SukkoPera/OpenAmigaJoyMouseSwitcher/enclosure/README.md

# How to print

Use the 2 STL files into your favorite slicer as [Ultimaker Cura]( https://ultimaker.com/software/ultimaker-cura)

# How to improve current version

Src is in SCAD code language : [OpenAmigaJoyMouseSwitcher_Case.scad](./OpenAmigaJoyMouseSwitcher_Case.scad)

It can be modified with [Open SCAD](https://openscad.org/)

Note that the `which` variable allow you to :

- `0` display both part of the case,
- `1` display bottom part of the case (for stl export),
- `2` display top part of the case (for stl export).
