SukkoPera/OpenAmigaJoyMouseSwitcher/doc/render-bottom.png

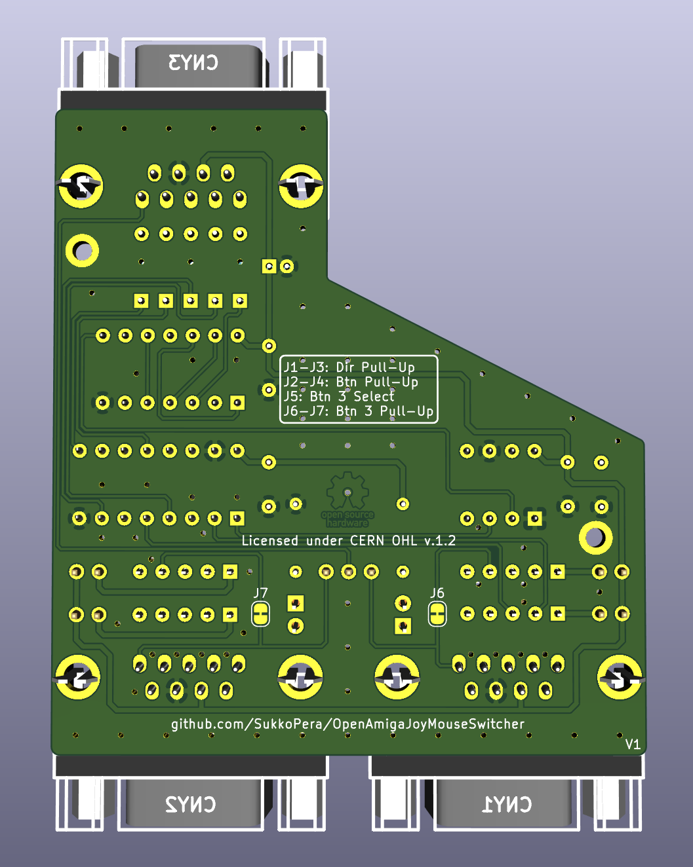
doc/render-bottom.png
