SukkoPera/OpenAmigaJoyMouseSwitcher/enclosure/OpenAmigaJoyMouseSwitcher_Case_Top.stl

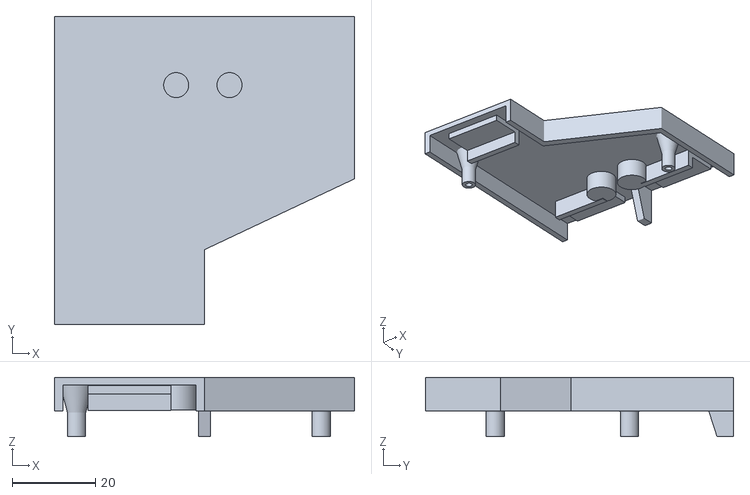
[picture p3: CAD file, 2023-03-22]
enclosure/OpenAmigaJoyMouseSwitcher_Case_Top.stl
72.0 x 74.0 x 14.2
