SukkoPera/OpenAmigaJoyMouseSwitcher/enclosure/OpenAmigaJoyMouseSwitcher_Case_Bottom.stl

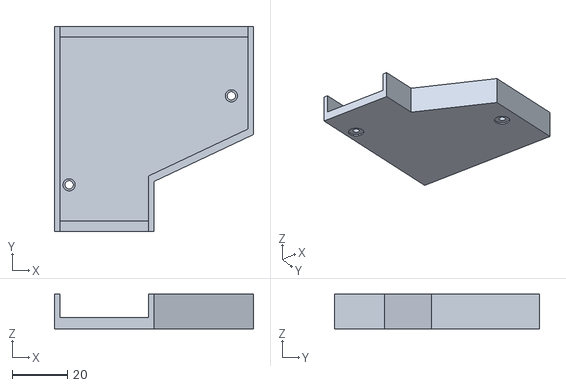
[picture p4: CAD file, 2023-03-22]
enclosure/OpenAmigaJoyMouseSwitcher_Case_Bottom.stl
72.0 x 74.0 x 12.5
