SukkoPera/OpenAmigaJoyMouseSwitcher/doc/schematic.pdf

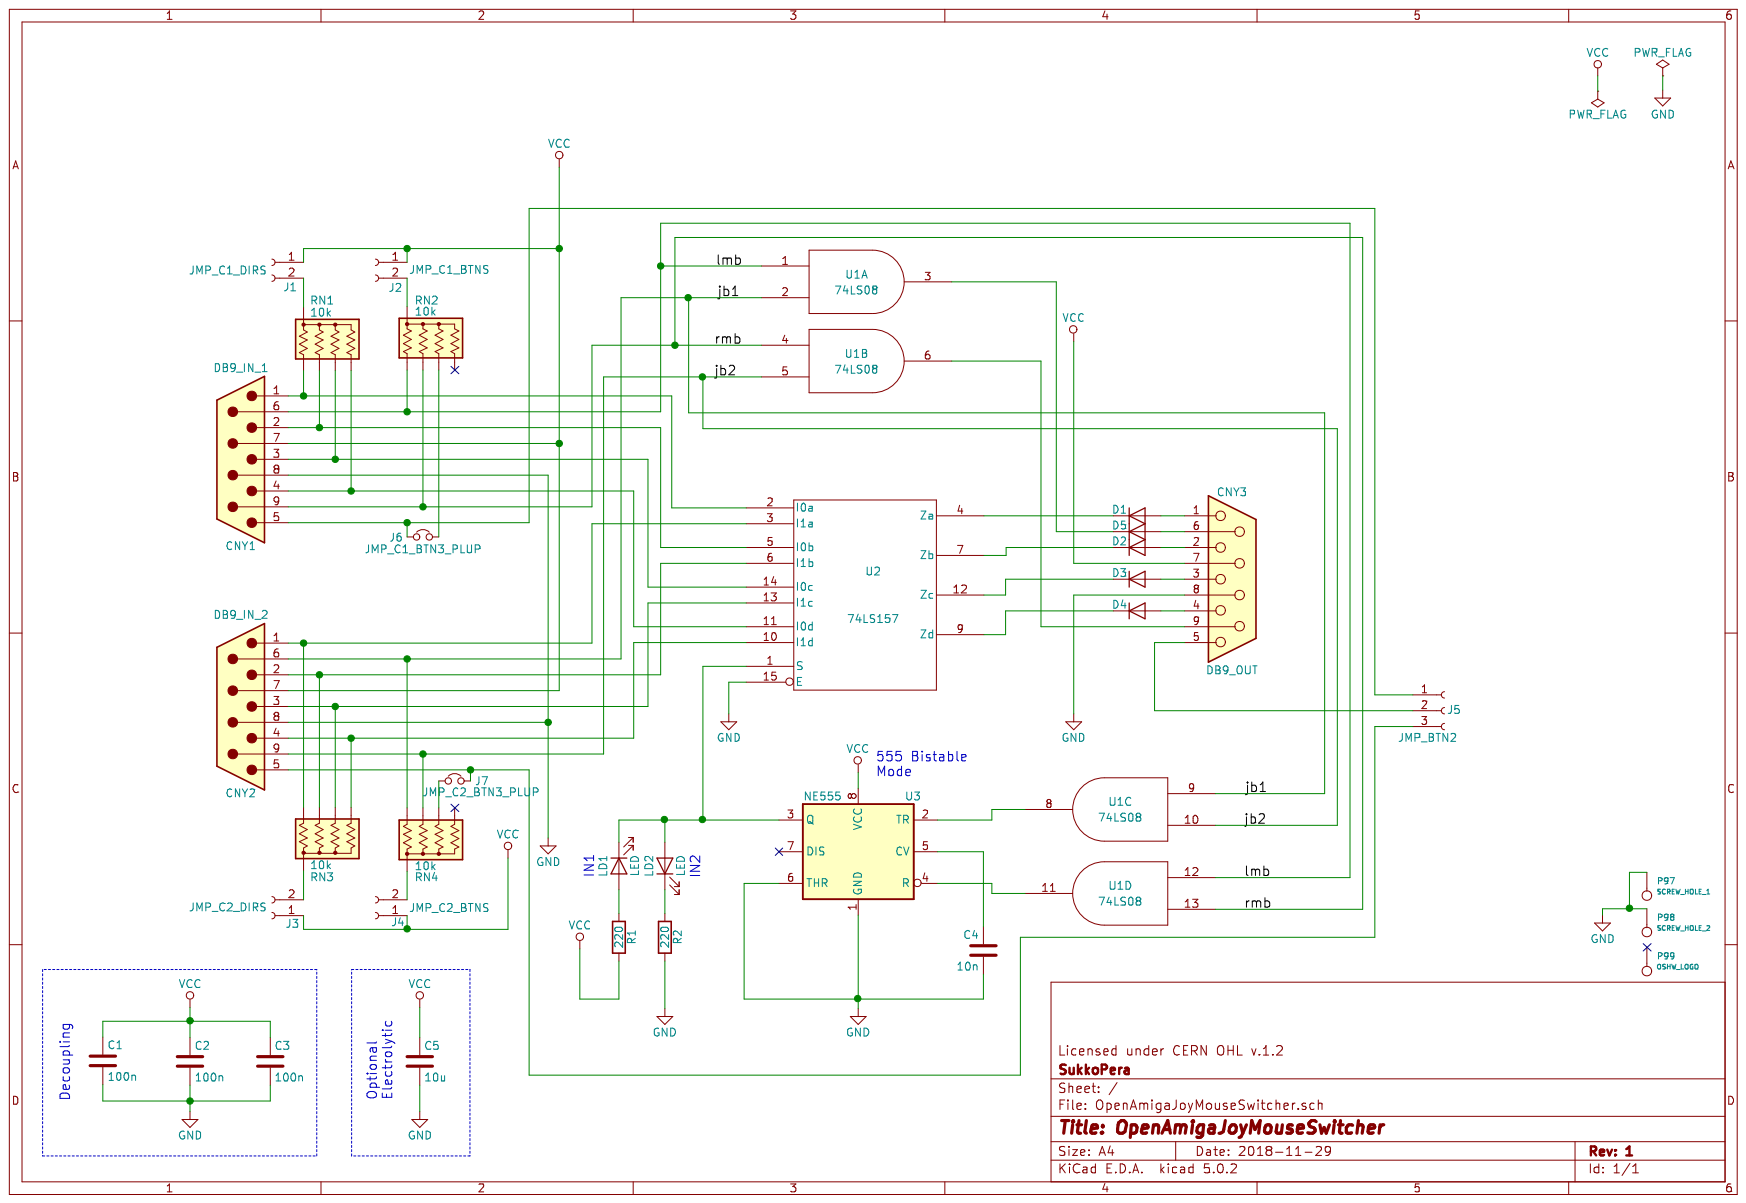
[picture p5: page 1]
