SukkoPera/OpenAmigaJoyMouseSwitcher/CHANGES.md

## CHANGES

Any modifications to the OpenAmigaJoyMouseSwitcher design and documentation made by any Licensee MUST be noted in this file, as per *section 3.4.b* of the [license](LICENSE.pdf).

### (Date) - (Author)
(Description)
