SukkoPera/OpenAmigaJoyMouseSwitcher/(threads)

Thread 3 (2019-12-01):

Documentation improvement: Parts

Cybolic, 2019-12-01:
I may just be new to the process, but I haven't been able to find a list of the parts that need to be soldered on to this board. I've tried googling for some of the numbers listed on the schematic, but with little success.
Could the documentation be updated to include a list of the parts needed, apart from just the pcb?

SukkoPera, 2019-12-01:
What you're looking for is called BOM (Bill Of Materials), and you can find it under Releases in the top bar.

Cybolic, 2019-12-01:
Thanks for the help! Do you happen to have a more detailed version of this?
I'm new to building things like this and a little more information would be very helpful. For example, C5 needs a 10μF capacitor but what voltage rating? U3 needs an NE555 but does it make a difference whether it's an NE555N or NE555P (I hear the voltage ratings are different on these)?
Are these things already in the files somewhere or is it up to each builder to figure out?

SukkoPera, 2019-12-01:
This things are usually up to the builder. Usually, detailed instructions are given only when a somewhat specific part is needed, otherwise indcation are pretty generic, as actually:
- C5 is not needed, all boards I've build are fine without it. If you really wanna use it, any voltage will be fine, since I think the lowest you will find are 16V, and there's nothing higher than 5V on the board, as you say.
- Literally any NE555 will be fine. I don't even know which ones I use, lol :).

So all you need is just common sense and maybe a bit of googling, but there's not really much that can go wrong.

Cybolic, 2019-12-01:
Alright, that calms me down a bit; thanks again for the help :)
I'm completely new to picking my own parts and building anything that doesn't just require adding wires to something. I've already burned out one of my CIA chips - by plugging in a joystick while the system was on, the very reason I'm looking to build your switcher - so I'm a bit paranoid that I might mess something up.

SukkoPera, 2019-12-02:
Don't worry, you just need to make up some experience :).

Closed 2019-12-01.

Thread 4 (2021-07-03):

Why D6 was removed?

lukasz-cielecki, 2021-07-03:
Could you please explain why D6 from original design was removed? I assume it was protecting rmb/jb2 pin. If it's not needed why lmb/jb1 diode (D5) is still there?

SukkoPera, 2021-07-03:
First of all all diodes serve no purpose on an Amiga computer. They are there just in case this adapter is connected to a C64.

On a C64 the direction and Button 1 lines are multiplexed with the keyboard matrix signals. You are not supposed to pull those lines high at any time, you are only allowed to set them low. If you connect push-pull outputs you need to put diodes inbetween in order to avoid the joystick to interfere with the keyboard scanning. See OpenC64MegadrivePadAdapter for more details.

Button 2, instead, is using pin 9, which in theory was designed to read analog controls (think paddles or basically a potentiometer), which means you are free to put any voltage in the 0-5V range on it.

The Amiga works mostly the same, if you look at the schematics you'll notice that pins 5 and 9 go to Paula, which has the analog read circuit, while pin 6 (Button 1) goes to one of the CIAs, which can only read digital inputs.

lukasz-cielecki, 2021-07-03:
Thank you for detailed explanation!

Closed 2021-07-03.

Thread 6 (2024-02-26):

Tankmouse | Mousescrolling doesn't work anymore

StevenHachel, 2024-02-26:
Hello,

If this adapter is connected, scrolling with the tank mouse no longer works. Are any signals filtered out?

Steff

StevenHachel, 2024-02-26:
Thanks for the quick reply.
Unfortunately I can't answer that for you.
I would have to check to see which signals are not being allowed through or cannot be processed.

Steven

StevenHachel, 2024-02-26:
Using the Rawkey (Aminet) tool I get the following values for the mouse wheel:
WhellBac CODE $007B QUAL $0000
WhellFor CODE $007A QUAL $0000

SukkoPera, 2024-02-27:
Those are probably "synthetic" software events that get generated when the mouse sends the scroll events. The latter is what we need to figure out. All pins get through (for pin 5 you need to move the jumper), but the pins are monodirectional when the switcher is in the path. If the Amiga needs to send signals to the mouse to get scrolling events, it won't work (and it's actually dangerous). It's the same reason why CD32 controllers don't work.

StevenHachel, 2024-02-27:
Okay, thanks for the detailed answer. Then I'll have to live with it and it's not a problem for me. At least now I know.

Greetings and thanks
Steven

SukkoPera, 2024-02-27:
Let me reopen this. It would be good if anyone could help with the scrolling protocol, at least to understand whether the switcher just prevents that from working or if any hardware is put at risk.

StevenHachel, 2024-02-27:
Okay, that makes sense. 😊

StevenHachel, 2024-05-16:
Is there any news regarding this?

SukkoPera, 2024-05-17:
Nope, no one has provided any information so far and I'm not actively working on it.

Thread 7 (2024-06-14):

Right mouse button does not work

Sir-Zodiac, 2024-06-14:
I testet 2 mice in OS 3.9 with an Amiga 1200 rev.2B and the switcher is Version 1.2 Without the switcher they both work fine. With the switcher the right mouse button is not recognized. I removed the jumpers but no luck.
The mice are a Logitech PS2 with a Cocolino and a Dell USB/PS2 Mouse with a Micromys V5 Adapter.

SukkoPera, 2024-06-14:
Does your board have 5 o 6 diodes close to the output connector? What chip did you use for U1?

Sir-Zodiac, 2024-06-14:
I bought it from Ebay. At the single connector end I see 5 diodes.
I assume the chip next to the diodes is U1. It reads SN74LS08N.
I see that C5 is not soldered onto the board.

SukkoPera, 2024-06-14:
Ok, I don't mean to be rude, but you should ask the seller for help. I'm tired of selfish people making money off my back, never contributing anything to my projects, using components of doubious origin and then leaving it all to me when it comes to support.

I'm sorry, but he got the money, he owes you support.

Closed 2024-06-14.
