SukkoPera/OpenAmigaJoyMouseSwitcher/(commit log)

2018-08-18 Ready for V1
    [OpenAmigaJoyMouseSwitcher.kicad_pcb, OpenAmigaJoyMouseSwitcher.sch]
2018-08-18 No mention of mouse/joystick, just IN1/2
    [OpenAmigaJoyMouseSwitcher.kicad_pcb]
2018-08-18 Add screw holes and change OSHW logo
    [OpenAmigaJoyMouseSwitcher.kicad_pcb, OpenAmigaJoyMouseSwitcher.sch]
2018-09-17 Add optional electrolytic cap
    [OpenAmigaJoyMouseSwitcher.kicad_pcb, OpenAmigaJoyMouseSwitcher.sch]
2018-09-17 Add diode on B2
    [OpenAmigaJoyMouseSwitcher.kicad_pcb, OpenAmigaJoyMouseSwitcher.sch]
2018-11-23 Use LDx references for LEDs and add anode marker
    [OpenAmigaJoyMouseSwitcher.kicad_pcb, OpenAmigaJoyMouseSwitcher.sch]
2018-11-23 Align right resistor arrays
    [OpenAmigaJoyMouseSwitcher.kicad_pcb]
2018-11-23 Align some vias
    [OpenAmigaJoyMouseSwitcher.kicad_pcb, OpenAmigaJoyMouseSwitcher.sch]
2018-11-29 Remove D6
    [OpenAmigaJoyMouseSwitcher.kicad_pcb, OpenAmigaJoyMouseSwitcher.sch]
2019-02-05 Add/Fix dimensions
    [OpenAmigaJoyMouseSwitcher.kicad_pcb]
2019-02-24 Final touches
    [OpenAmigaJoyMouseSwitcher.kicad_pcb, OpenAmigaJoyMouseSwitcher.sch]
2019-02-24 Add schematics PDF
2019-05-16 Fix double license claim and PCB in Kicad 5.1
    [OpenAmigaJoyMouseSwitcher.kicad_pcb]
2020-12-29 Ground DB-9 shields
    [OpenAmigaJoyMouseSwitcher.kicad_pcb, OpenAmigaJoyMouseSwitcher.sch]
2023-03-20 feat: add 3D printed enclosure
    [OpenAmigaJoyMouseSwitcher_Case.scad, OpenAmigaJoyMouseSwitcher_Case_Bottom.stl, OpenAmigaJoyMouseSwitcher_Case_Top.stl]
