SukkoPera/OpenAmigaJoyMouseSwitcher/(notices)

Notices in the files:
OpenAmigaJoyMouseSwitcher.sch:
Licensed under CERN OHL v.1.2
